johanputzolu-cmd/Onerom/sdrr-pcb/unverified/fire-24-e/fire-24-e-schematic.pdf

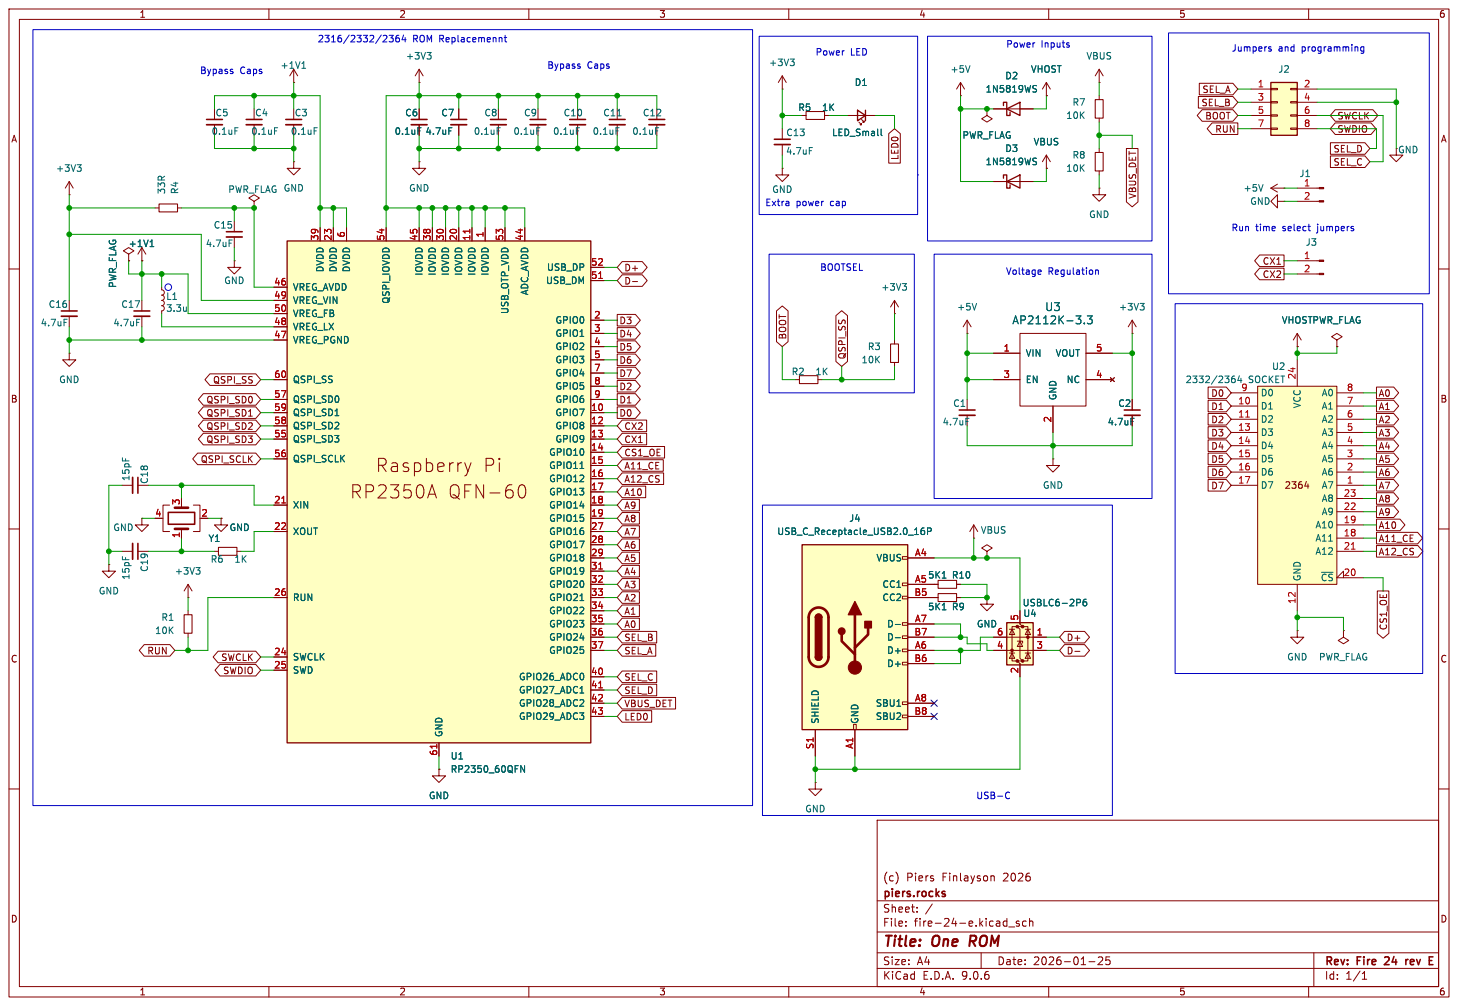
[picture p1: page 1]

Run time select jumpers

6 QSPI_IOVDD 54 IOVDD 45 IOVDD 38 GND 61 IOVDD 30 IOVDD 20 IOVDD 11 IOVDD

File: fire-24-e.kicad_sch Sheet: / piers.rocks

Id: 1/1 Title: One ROM
