johanputzolu-cmd/Onerom/sdrr-pcb/verified/fire-28-a3/kicad/fire-28-a3.kicad_pcb

## KiCad design sdrr-pcb/verified/fire-28-a3/kicad/fire-28-a3.kicad_pcb (2026-01-26)

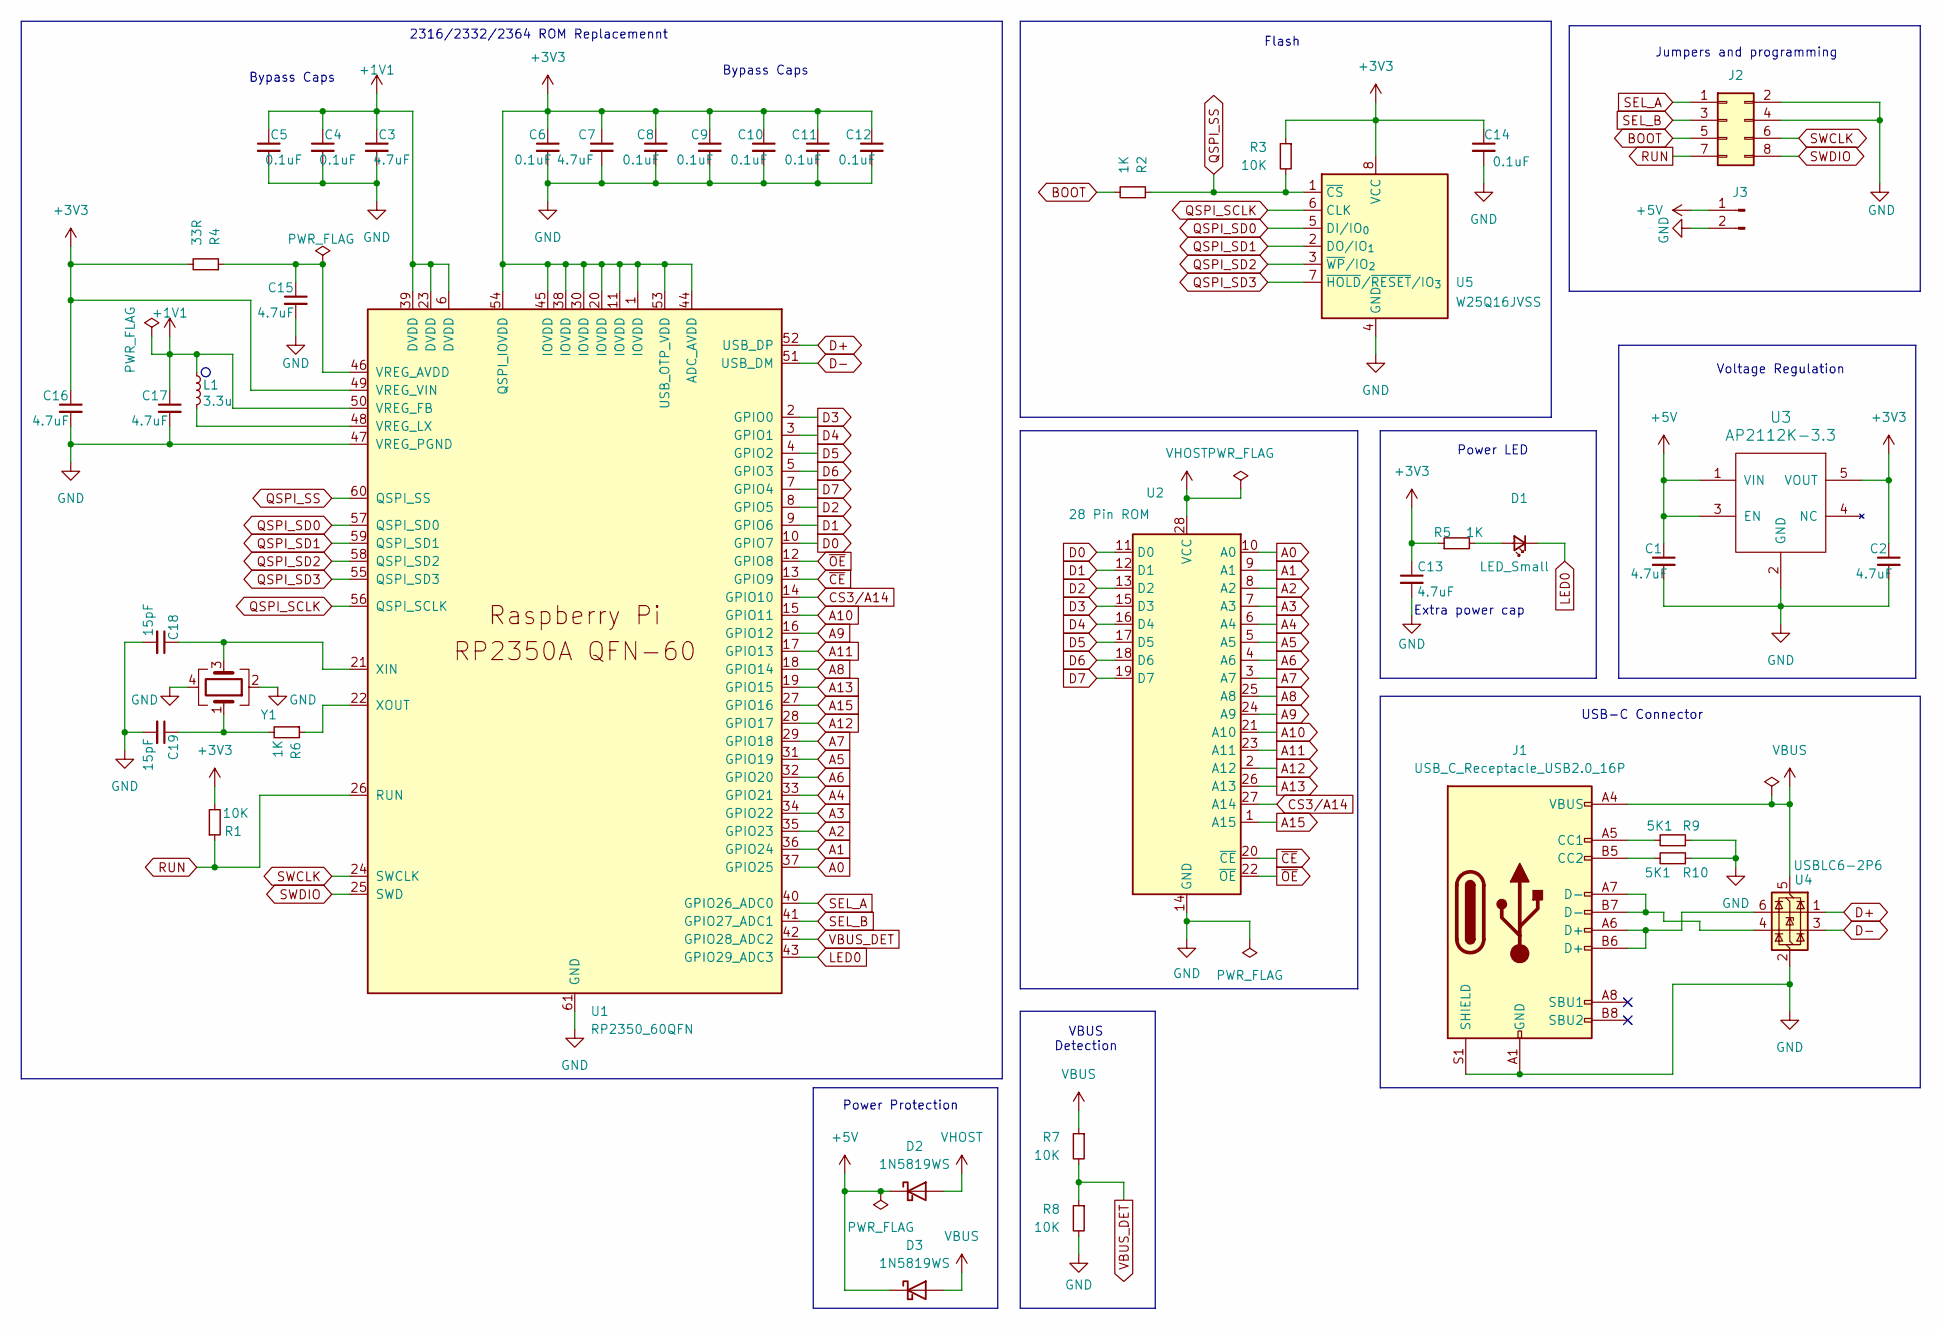
[picture p2: schematic fire-28-a3.kicad_sch, One ROM]

Parts:
C1, C2, C3, C7, C13, C15: 4.7uF; C_0402_1005Metric; LCSC C23733
C4, C5, C6, C8, C9, C10, C11, C12, C14: 0.1uF; C_0402_1005Metric; LCSC C1525
C16, C17: 4.7uF; C_0402_1005Metric_small_pads; LCSC C23733
C18, C19: 15pF; C_0402_1005Metric; LCSC C1548
D1: LED_Small; LED_0603_1608Metric; LCSC C2286
D2, D3: 1N5819WS; D_SOD-323; LCSC C191023
J1: USB_C_Receptacle_USB2.0_16P; USB_C_connector_c2765186; LCSC C2765186
J2: Conn_02x04_Odd_Even; PinHeader_2x04_P2.54mm_Vertical custom silkscreen
J3: Conn_01x02_Pin; PinHeader_1x02_P2.54mm_Vertical
L1: 3.3u; L_pol_2016; LCSC C42411119
R1, R3, R7, R8: 10K; R_0402_1005Metric; LCSC C25744
R2, R5, R6: 1K; R_0402_1005Metric; LCSC C11702
R4: 33R; R_0402_1005Metric; LCSC C25105
R9, R10: 5K1; R_0402_1005Metric; LCSC C25905
U1: RP2350_60QFN; RP2350-QFN-60-1EP_7x7_P0.4mm_EP3.4x3.4mm_ThermalVias; LCSC C42411118
U2: 28 Pin ROM; 28 pin rom footprint
U3: AP2112K-3.3; SOT-23-5; LCSC C51118
U4: USBLC6-2P6; SOT-666; LCSC C15999
U5: W25Q16JVSS; Winbond_USON-8-1EP_3x2mm_P0.5mm_EP0.2x1.6mm; LCSC C2843335
Y1: Crystal_GND24; Crystal_SMD_Abracon_ABM8G-4Pin_3.2x2.5mm; LCSC C20625731

Connections:
+1V1: C3.1, C4.1, C5.1, C17.1, L1.1, U1.6 (DVDD), U1.23 (DVDD), U1.39 (DVDD), U1.50 (VREG_FB)
+3V3: C2.1, C6.1, C7.1, C8.1, C9.1, C10.1, C11.1, C12.1, C13.1, C14.1, C16.1, R1.2, R3.1, R4.2, R5.1, U1.1 (IOVDD), U1.11 (IOVDD), U1.20 (IOVDD), U1.30 (IOVDD), U1.38 (IOVDD), U1.44 (ADC_AVDD), U1.45 (IOVDD), U1.49 (VREG_VIN), U1.53 (USB_OTP_VDD), U1.54 (QSPI_IOVDD), U3.5 (VOUT), U5.8 (VCC)
+5V: C1.1, D2.1 (K), D3.1 (K), J3.1, U3.1 (VIN), U3.3 (EN)
A0: U1.37 (GPIO25), U2.10 (A0)
A1: U1.36 (GPIO24), U2.9 (A1)
A2: U1.35 (GPIO23), U2.8 (A2)
A3: U1.34 (GPIO22), U2.7 (A3)
A4: U1.33 (GPIO21), U2.6 (A4)
A5: U1.31 (GPIO19), U2.5 (A5)
A6: U1.32 (GPIO20), U2.4 (A6)
A7: U1.29 (GPIO18), U2.3 (A7)
A8: U1.18 (GPIO14), U2.25 (A8)
A9: U1.16 (GPIO12), U2.24 (A9)
A10: U1.15 (GPIO11), U2.21 (A10)
A11: U1.17 (GPIO13), U2.23 (A11)
A12: U1.28 (GPIO17), U2.2 (A12)
A13: U1.19 (GPIO15), U2.26 (A13)
A15: U1.27 (GPIO16), U2.1 (A15)
BOOT: J2.5, R2.2
CS3/A14: U1.14 (GPIO10), U2.27 (A14)
D0: U1.10 (GPIO7), U2.11 (D0)
D1: U1.9 (GPIO6), U2.12 (D1)
D2: U1.8 (GPIO5), U2.13 (D2)
D3: U1.2 (GPIO0), U2.15 (D3)
D4: U1.3 (GPIO1), U2.16 (D4)
D5: U1.4 (GPIO2), U2.17 (D5)
D6: U1.5 (GPIO3), U2.18 (D6)
D7: U1.7 (GPIO4), U2.19 (D7)
D+: U1.52 (USB_DP), U4.1 (I/O1)
D-: U1.51 (USB_DM), U4.3 (I/O2)
GND: C1.2, C2.2, C3.2, C4.2, C5.2, C6.2, C7.2, C8.2, C9.2, C10.2, C11.2, C12.2, C13.2, C14.2, C15.2, C16.2, C17.2, C18.2, C19.2, J1.A1 (GND), J1.A12 (GND), J1.B1 (GND), J1.B12 (GND), J1.S1 (SHIELD), J2.2, J2.4, J3.2, R8.2, R9.1, R10.1, U1.47 (VREG_PGND), U1.61 (GND), U2.14 (GND), U3.2 (GND), U4.2 (GND), U5.4 (GND), Y1.2, Y1.4
LED0: D1.1 (K), U1.43 (GPIO29_ADC3)
unnamed: C19.1, R6.2, Y1.1
unnamed: D1.2 (A), R5.2
unnamed: J1.A5 (CC1), R9.2
unnamed: J1.B5 (CC2), R10.2
unnamed: J1.A6 (D+), J1.B6 (D+), U4.6 (I/O1)
unnamed: J1.A7 (D-), J1.B7 (D-), U4.4 (I/O2)
unnamed: C15.1, R4.1, U1.46 (VREG_AVDD)
unnamed: L1.2, U1.48 (VREG_LX)
unnamed: C18.1, U1.21 (XIN), Y1.3
unnamed: R6.1, U1.22 (XOUT)
QSPI_SCLK: U1.56 (QSPI_SCLK), U5.6 (CLK)
QSPI_SD0: U1.57 (QSPI_SD0), U5.5 (DI/IO_{0})
QSPI_SD1: U1.59 (QSPI_SD1), U5.2 (DO/IO_{1})
QSPI_SD2: U1.58 (QSPI_SD2), U5.3 (~WP/IO_{2})
QSPI_SD3: U1.55 (QSPI_SD3), U5.7 (~HOLD/~RESET/IO_{3})
QSPI_SS: R2.1, R3.2, U1.60 (QSPI_SS), U5.1 (~CS)
RUN: J2.7, R1.1, U1.26 (RUN)
SEL_A: J2.1, U1.40 (GPIO26_ADC0)
SEL_B: J2.3, U1.41 (GPIO27_ADC1)
SWCLK: J2.6, U1.24 (SWCLK)
SWDIO: J2.8, U1.25 (SWD)
VBUS: D3.2 (A), J1.A4 (VBUS), J1.A9 (VBUS), J1.B4 (VBUS), J1.B9 (VBUS), R7.1, U4.5 (VBUS)
VBUS_DET: R7.2, R8.1, U1.42 (GPIO28_ADC2)
VHOST: D2.2 (A), U2.28 (VCC)
~CE: U1.13 (GPIO9), U2.20 (~CE)
~OE: U1.12 (GPIO8), U2.22 (~OE)

Notes on the sheet:
USB-C Connector
Voltage Regulation
Extra power cap
2316/2332/2364 ROM Replacemennt
Bypass Caps
Power LED
Power Protection
VBUS Detection
Flash
Jumpers and programming

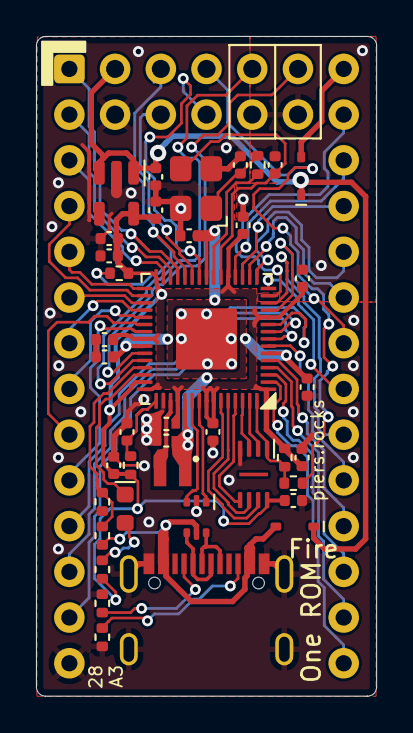
[picture p3: board fire-28-a3.kicad_pcb from above]

Board: 2 copper layers, 18.9 x 36.7 mm, 42 parts (0 on the bottom side), 58 nets.
