johanputzolu-cmd/Onerom/(commit log)

2026-01-22 create 40 pin config file - tests run
2026-01-26 add fire-28-a3 kicad files
    [fire-28-a3.kicad_pcb, fire-28-a3.kicad_sch]
2026-01-27 fix 64 bit logging issue
    [main.c]
2026-01-27 fix stm32 flashing
2026-01-27 fix 23xxx 28 pin ROMs
