johanputzolu-cmd/Onerom/(notices)

Notices in the files:
sdrr-pcb/verified/fire-28-a3/kicad/fire-28-a3.kicad_pcb:
(c) 2025 piers.rocks
